soggybag/Casualty-6-SMD/Casualty6_render_bottom.png

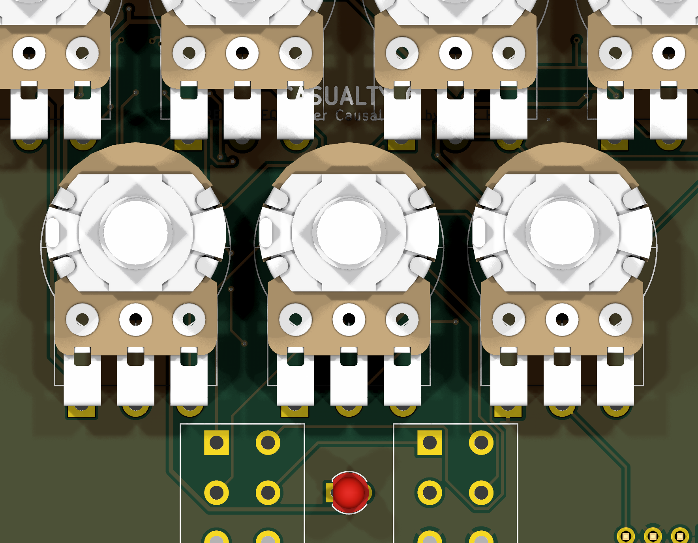
Casualty6_render_bottom.png
