soggybag/Casualty-6-SMD/Casualty6_render_top.png

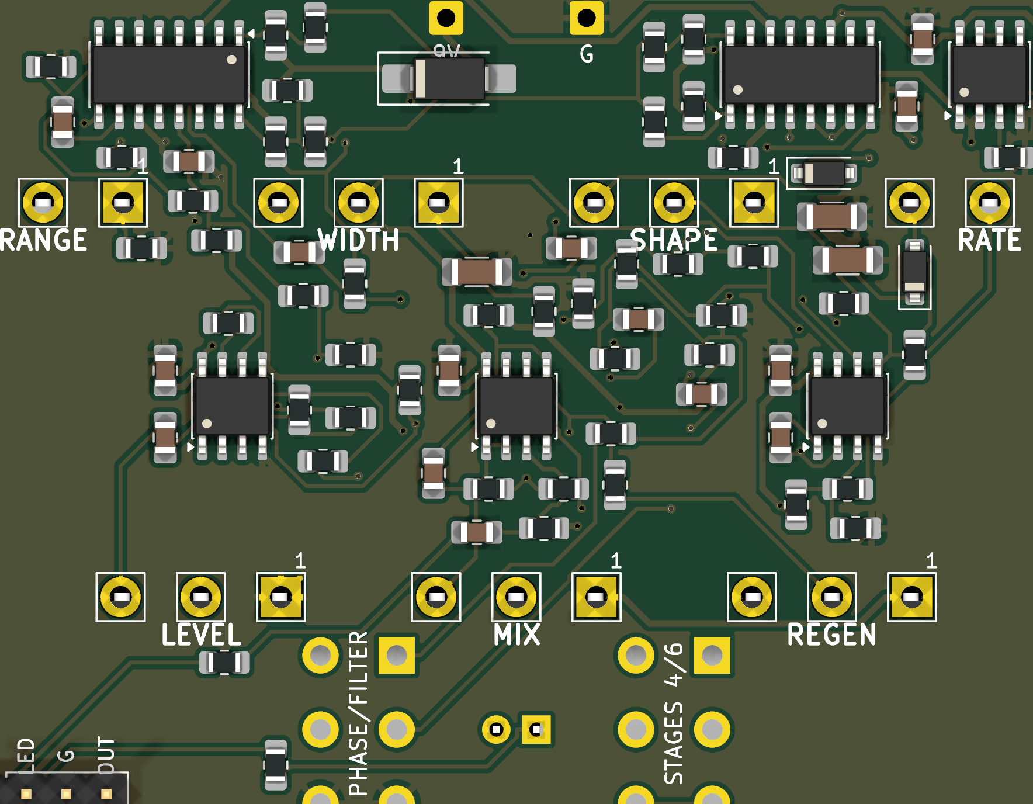
Casualty6_render_top.png
