soggybag/Casualty-6-SMD/archive/v1.0/parts.csv

Reference | Value | Footprint | Side | X mm | Y mm | Rotation | LCSC | Fitted by
C1 | 33n | Capacitor_SMD:C_0805_2012Metric_Pad1.18x1.45mm_HandSolder | front | 136.25 | 111.25 | 0.0 | C1739 | JLC
C2 | 33n | Capacitor_SMD:C_0805_2012Metric_Pad1.18x1.45mm_HandSolder | front | 121.25 | 103.0 | 90.0 | C1739 | JLC
C3 | 33n | Capacitor_SMD:C_0805_2012Metric_Pad1.18x1.45mm_HandSolder | front | 161.75 | 120.25 | 0.0 | C1739 | JLC
C4 | 33n | Capacitor_SMD:C_0805_2012Metric_Pad1.18x1.45mm_HandSolder | front | 153.5 | 111.0 | 0.0 | C1739 | JLC
C5 | 100n | Capacitor_SMD:C_0805_2012Metric_Pad1.18x1.45mm_HandSolder | front | 147.5 | 129.0 | 0.0 | C49678 | JLC
C6 | 4n7 | Capacitor_SMD:C_0805_2012Metric_Pad1.18x1.45mm_HandSolder | front | 144.75 | 125.25 | 90.0 | C1744 | JLC
C7 | 47n | Capacitor_SMD:C_0805_2012Metric_Pad1.18x1.45mm_HandSolder | front | 157.75 | 115.5 | 0.0 | C53134 | JLC
C8 | 1u | Capacitor_SMD:C_0805_2012Metric_Pad1.18x1.45mm_HandSolder | front | 127.75 | 123.0 | 90.0 | C28323 | JLC
C9 | 10n | Capacitor_SMD:C_0805_2012Metric_Pad1.18x1.45mm_HandSolder | front | 166.75 | 123.0 | 90.0 | C1710 | JLC
C10 | 22u | Capacitor_SMD:C_1206_3216Metric_Pad1.33x1.80mm_HandSolder | front | 170.0 | 109.0 | 0.0 | C12891 | JLC
C11 | 22u | Capacitor_SMD:C_1206_3216Metric_Pad1.33x1.80mm_HandSolder | front | 171.0 | 111.75 | 0.0 | C12891 | JLC
C12 | 22u | Capacitor_SMD:C_1206_3216Metric_Pad1.33x1.80mm_HandSolder | front | 147.5 | 112.5 | 0.0 | C12891 | JLC
C13 | 22u | Capacitor_SMD:C_1206_3216Metric_Pad1.33x1.80mm_HandSolder | front | 186.75 | 111.25 | 0.0 | C12891 | JLC
C14 | 10u | Capacitor_SMD:C_0805_2012Metric_Pad1.18x1.45mm_HandSolder | front | 185.0 | 100.25 | 0.0 | C15850 | JLC
C15 | 100n | Capacitor_SMD:C_0805_2012Metric_Pad1.18x1.45mm_HandSolder | front | 129.25 | 105.5 | 0.0 | C49678 | JLC
C16 | 100n | Capacitor_SMD:C_0805_2012Metric_Pad1.18x1.45mm_HandSolder | front | 174.75 | 102.0 | 90.0 | C49678 | JLC
C17 | 100n | Capacitor_SMD:C_0805_2012Metric_Pad1.18x1.45mm_HandSolder | front | 145.75 | 118.75 | 90.0 | C49678 | JLC
C18 | 100n | Capacitor_SMD:C_0805_2012Metric_Pad1.18x1.45mm_HandSolder | front | 127.75 | 118.75 | 90.0 | C49678 | JLC
C19 | 100n | Capacitor_SMD:C_0805_2012Metric_Pad1.18x1.45mm_HandSolder | front | 175.75 | 97.75 | 90.0 | C49678 | JLC
C20 | 100n | Capacitor_SMD:C_0805_2012Metric_Pad1.18x1.45mm_HandSolder | front | 166.75 | 118.75 | 90.0 | C49678 | JLC
D1 | 1N4148W | Diode_SMD:D_SOD-123 | front | 169.5 | 106.25 | 0.0 | C81598 | JLC
D2 | 1N4148W | Diode_SMD:D_SOD-123 | front | 175.25 | 112.5 | 90.0 | C81598 | JLC
D3 | SS14 | Diode_SMD:D_SMA_Handsoldering | front | 145.75 | 100.25 | 0.0 | C2480 | JLC
D4 | LED | LED_THT:LED_D3.0mm | back | 151.27 | 141.5 | 180.0 |  | hand
J1 | 9V | Connector_Wire:SolderWire-0.5sqmm_1x01_D0.9mm_OD2.1mm | front | 145.55 | 96.4 | 0.0 |  | hand
J2 | G | Connector_Wire:SolderWire-0.5sqmm_1x01_D0.9mm_OD2.1mm | front | 154.45 | 96.4 | 0.0 |  | hand
J3 | IN/LED/GND/OUT | Connector_PinHeader_2.54mm:PinHeader_1x04_P2.54mm_Vertical | front | 116.4 | 145.6 | 90.0 |  | hand
J4 | IG | Connector_Wire:SolderWire-0.5sqmm_1x01_D0.9mm_OD2.1mm | front | 187.6 | 96.4 | 0.0 |  | hand
J5 | OG | Connector_Wire:SolderWire-0.5sqmm_1x01_D0.9mm_OD2.1mm | front | 112.4 | 96.4 | 0.0 |  | hand
J6 | CV IN | Connector_Wire:SolderWire-0.5sqmm_1x01_D0.9mm_OD2.1mm | front | 112.5 | 102.5 | 0.0 |  | hand
J7 | LFO OUT | Connector_Wire:SolderWire-0.5sqmm_1x01_D0.9mm_OD2.1mm | front | 112.5 | 114.0 | 0.0 |  | hand
R1 | 27k | Resistor_SMD:R_0805_2012Metric_Pad1.20x1.40mm_HandSolder | front | 139.75 | 113.25 | 90.0 | C17593 | JLC
R2 | 27k | Resistor_SMD:R_0805_2012Metric_Pad1.20x1.40mm_HandSolder | front | 125.0 | 105.25 | 0.0 | C17593 | JLC
R3 | 2k | Resistor_SMD:R_0805_2012Metric_Pad1.20x1.40mm_HandSolder | front | 134.75 | 104.25 | 90.0 | C17604 | JLC
R4 | 10k | Resistor_SMD:R_0805_2012Metric_Pad1.20x1.40mm_HandSolder | front | 120.5 | 99.5 | 0.0 | C17414 | JLC
R5 | 15k | Resistor_SMD:R_0805_2012Metric_Pad1.20x1.40mm_HandSolder | front | 137.25 | 97.0 | 90.0 | C17475 | JLC
R6 | 470k | Resistor_SMD:R_0805_2012Metric_Pad1.20x1.40mm_HandSolder | front | 134.75 | 97.5 | 90.0 | C17709 | JLC
R7 | 27k | Resistor_SMD:R_0805_2012Metric_Pad1.20x1.40mm_HandSolder | front | 129.5 | 108.0 | 0.0 | C17593 | JLC
R8 | 27k | Resistor_SMD:R_0805_2012Metric_Pad1.20x1.40mm_HandSolder | front | 136.5 | 114.0 | 0.0 | C17593 | JLC
R9 | 2k | Resistor_SMD:R_0805_2012Metric_Pad1.20x1.40mm_HandSolder | front | 131.0 | 110.5 | 0.0 | C17604 | JLC
R10 | 10k | Resistor_SMD:R_0805_2012Metric_Pad1.20x1.40mm_HandSolder | front | 139.5 | 117.75 | 0.0 | C17414 | JLC
R11 | 15k | Resistor_SMD:R_0805_2012Metric_Pad1.20x1.40mm_HandSolder | front | 137.25 | 104.25 | 90.0 | C17475 | JLC
R12 | 470k | Resistor_SMD:R_0805_2012Metric_Pad1.20x1.40mm_HandSolder | front | 135.5 | 101.0 | 0.0 | C17709 | JLC
R13 | 27k | Resistor_SMD:R_0805_2012Metric_Pad1.20x1.40mm_HandSolder | front | 156.0 | 122.75 | 0.0 | C17593 | JLC
R14 | 27k | Resistor_SMD:R_0805_2012Metric_Pad1.20x1.40mm_HandSolder | front | 157.0 | 112.0 | 90.0 | C17593 | JLC
R15 | 2k | Resistor_SMD:R_0805_2012Metric_Pad1.20x1.40mm_HandSolder | front | 162.25 | 117.75 | 0.0 | C17604 | JLC
R16 | 10k | Resistor_SMD:R_0805_2012Metric_Pad1.20x1.40mm_HandSolder | front | 154.25 | 114.5 | 90.0 | C17414 | JLC
R17 | 15k | Resistor_SMD:R_0805_2012Metric_Pad1.20x1.40mm_HandSolder | front | 158.75 | 103.0 | 90.0 | C17475 | JLC
R18 | 470k | Resistor_SMD:R_0805_2012Metric_Pad1.20x1.40mm_HandSolder | front | 161.25 | 102.0 | 90.0 | C17709 | JLC
R19 | 27k | Resistor_SMD:R_0805_2012Metric_Pad1.20x1.40mm_HandSolder | front | 160.25 | 112.0 | 0.0 | C17593 | JLC
R20 | 27k | Resistor_SMD:R_0805_2012Metric_Pad1.20x1.40mm_HandSolder | front | 165.0 | 111.5 | 0.0 | C17593 | JLC
R21 | 2k | Resistor_SMD:R_0805_2012Metric_Pad1.20x1.40mm_HandSolder | front | 163.75 | 105.25 | 0.0 | C17604 | JLC
R22 | 10k | Resistor_SMD:R_0805_2012Metric_Pad1.20x1.40mm_HandSolder | front | 163.0 | 115.25 | 0.0 | C17414 | JLC
R23 | 15k | Resistor_SMD:R_0805_2012Metric_Pad1.20x1.40mm_HandSolder | front | 158.75 | 98.25 | 90.0 | C17475 | JLC
R24 | 470k | Resistor_SMD:R_0805_2012Metric_Pad1.20x1.40mm_HandSolder | front | 161.25 | 97.75 | 90.0 | C17709 | JLC
R25 | 1k | Resistor_SMD:R_0805_2012Metric_Pad1.20x1.40mm_HandSolder | front | 131.5 | 137.25 | 0.0 | C17513 | JLC
R26 | 1M | Resistor_SMD:R_0805_2012Metric_Pad1.20x1.40mm_HandSolder | front | 151.75 | 128.75 | 0.0 | C17514 | JLC
R27 | 10k | Resistor_SMD:R_0805_2012Metric_Pad1.20x1.40mm_HandSolder | front | 148.25 | 126.25 | 0.0 | C17414 | JLC
R28 | 10k | Resistor_SMD:R_0805_2012Metric_Pad1.20x1.40mm_HandSolder | front | 148.25 | 115.25 | 0.0 | C17414 | JLC
R29 | 10k | Resistor_SMD:R_0805_2012Metric_Pad1.20x1.40mm_HandSolder | front | 153.0 | 126.25 | 0.0 | C17414 | JLC
R30 | 15k | Resistor_SMD:R_0805_2012Metric_Pad1.20x1.40mm_HandSolder | front | 156.25 | 126.0 | 90.0 | C17475 | JLC
R31 | 10k | Resistor_SMD:R_0805_2012Metric_Pad1.20x1.40mm_HandSolder | front | 156.25 | 118.0 | 0.0 | C17414 | JLC
R32 | 10k | Resistor_SMD:R_0805_2012Metric_Pad1.20x1.40mm_HandSolder | front | 143.25 | 120.0 | 90.0 | C17414 | JLC
R33 | 10k | Resistor_SMD:R_0805_2012Metric_Pad1.20x1.40mm_HandSolder | front | 139.5 | 121.75 | 0.0 | C17414 | JLC
R34 | 47k | Resistor_SMD:R_0805_2012Metric_Pad1.20x1.40mm_HandSolder | front | 137.75 | 124.5 | 0.0 | C17713 | JLC
R35 | 47k | Resistor_SMD:R_0805_2012Metric_Pad1.20x1.40mm_HandSolder | front | 136.25 | 121.25 | 90.0 | C17713 | JLC
R36 | 68k | Resistor_SMD:R_0805_2012Metric_Pad1.20x1.40mm_HandSolder | front | 131.75 | 115.75 | 0.0 | C17801 | JLC
R37 | 220k | Resistor_SMD:R_0805_2012Metric_Pad1.20x1.40mm_HandSolder | front | 171.5 | 128.75 | 0.0 | C17556 | JLC
R38 | 220k | Resistor_SMD:R_0805_2012Metric_Pad1.20x1.40mm_HandSolder | front | 167.75 | 127.25 | 90.0 | C17556 | JLC
R39 | 220k | Resistor_SMD:R_0805_2012Metric_Pad1.20x1.40mm_HandSolder | front | 171.0 | 126.25 | 0.0 | C17556 | JLC
R40 | 220k | Resistor_SMD:R_0805_2012Metric_Pad1.20x1.40mm_HandSolder | front | 170.75 | 114.5 | 0.0 | C17556 | JLC
R41 | 1k | Resistor_SMD:R_0805_2012Metric_Pad1.20x1.40mm_HandSolder | front | 175.25 | 117.75 | 90.0 | C17513 | JLC
R42 | 47k | Resistor_SMD:R_0805_2012Metric_Pad1.20x1.40mm_HandSolder | front | 151.75 | 115.0 | 90.0 | C17713 | JLC
R43 | 2k2 | Resistor_SMD:R_0805_2012Metric_Pad1.20x1.40mm_HandSolder | front | 126.25 | 111.0 | 0.0 | C17520 | JLC
R44 | 1k | Resistor_SMD:R_0805_2012Metric_Pad1.20x1.40mm_HandSolder | front | 187.0 | 104.25 | 90.0 | C17513 | JLC
R45 | 100k | Resistor_SMD:R_0805_2012Metric_Pad1.20x1.40mm_HandSolder | front | 184.5 | 103.75 | 90.0 | C149504 | JLC
R46 | 100k | Resistor_SMD:R_0805_2012Metric_Pad1.20x1.40mm_HandSolder | front | 181.25 | 105.25 | 0.0 | C149504 | JLC
R47 | 4k7 | Resistor_SMD:R_0805_2012Metric_Pad1.20x1.40mm_HandSolder | front | 134.75 | 143.75 | 90.0 | C17673 | JLC
R48 | 10k | Resistor_SMD:R_0805_2012Metric_Pad1.20x1.40mm_HandSolder | front | 188.0 | 100.1 | 90.0 | C17414 | JLC
R49 | 6k8 | Resistor_SMD:R_0805_2012Metric_Pad1.20x1.40mm_HandSolder | front | 180.0 | 95.3 | 180.0 | C17772 | JLC
R50 | 10k | Resistor_SMD:R_0805_2012Metric_Pad1.20x1.40mm_HandSolder | front | 183.8 | 97.3 | 90.0 | C17414 | JLC
R51 | 10k | Resistor_SMD:R_0805_2012Metric_Pad1.20x1.40mm_HandSolder | front | 116.0 | 102.5 | 90.0 | C17414 | JLC
R52 | 1k | Resistor_SMD:R_0805_2012Metric_Pad1.20x1.40mm_HandSolder | front | 167.8 | 114.9 | 90.0 | C17513 | JLC
R53 | 1M | Resistor_SMD:R_0805_2012Metric_Pad1.20x1.40mm_HandSolder | front | 132.25 | 139.75 | 0.0 | C17514 | JLC
RV1 | C500k | UglyFace:Potentiometer_Alpha_16mm_Vertical | front | 180.0 | 108.11 | 0.0 |  | hand
RV2 | B1M | UglyFace:Potentiometer_Alpha_16mm_Vertical | front | 160.0 | 108.11 | 0.0 |  | hand
RV3 | B100k | UglyFace:Potentiometer_Alpha_16mm_Vertical | front | 140.0 | 108.11 | 0.0 |  | hand
RV4 | B10k | UglyFace:Potentiometer_Alpha_16mm_Vertical | front | 120.0 | 108.11 | 0.0 |  | hand
RV5 | B50k | UglyFace:Potentiometer_Alpha_16mm_Vertical | front | 170.0 | 133.1 | 0.0 |  | hand
RV6 | A100k | UglyFace:Potentiometer_Alpha_16mm_Vertical | front | 150.0 | 133.1 | 0.0 |  | hand
RV7 | A100k | UglyFace:Potentiometer_Alpha_16mm_Vertical | front | 130.0 | 133.1 | 0.0 |  | hand
SW1 | DPDT | Casualty:SW_Taiway_100_DPDT_PC | back | 160.0 | 141.5 | 0.0 |  | hand
SW2 | DPDT | Casualty:SW_Taiway_100_DPDT_PC | back | 140.0 | 141.5 | 0.0 |  | hand
U1 | LM13700 | Package_SO:SOIC-16_3.9x9.9mm_P1.27mm | front | 128.0 | 100.0 | -90.0 | C1346265 | JLC
U2 | LM13700 | Package_SO:SOIC-16_3.9x9.9mm_P1.27mm | front | 168.0 | 100.0 | 90.0 | C1346265 | JLC
U3 | TL072 | Package_SO:SOIC-8_3.9x4.9mm_P1.27mm | front | 150.0 | 121.0 | 90.0 | C6961 | JLC
U4 | TL072 | Package_SO:SOIC-8_3.9x4.9mm_P1.27mm | front | 132.0 | 121.0 | 90.0 | C6961 | JLC
U5 | TL072 | Package_SO:SOIC-8_3.9x4.9mm_P1.27mm | front | 180.0 | 100.0 | 90.0 | C6961 | JLC
U6 | TL072 | Package_SO:SOIC-8_3.9x4.9mm_P1.27mm | front | 171.0 | 121.0 | 90.0 | C6961 | JLC
