soggybag/Casualty-6-SMD/3dmodels/RV16AF-41.step

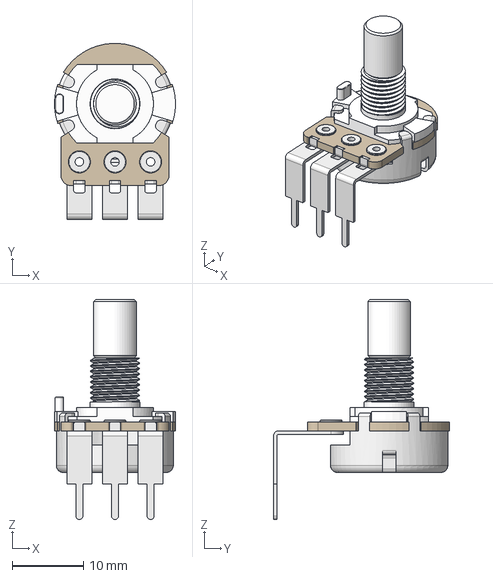
[picture p3: CAD file, 2026-10-15]
3dmodels/RV16AF-41.step
17.0 x 24.7 x 30.9 mm
