soggybag/Casualty-6-SMD/3dmodels/1590B.stp

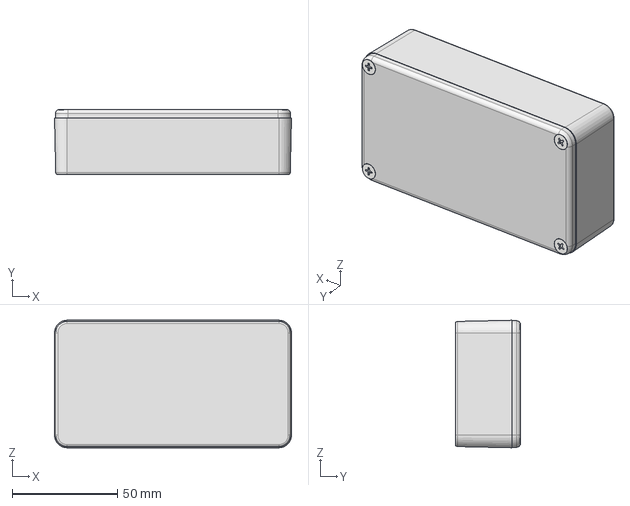
[picture p4: CAD file, 2026-10-15]
3dmodels/1590B.stp
112.4 x 31.0 x 60.5 mm
