soggybag/Casualty-6-SMD/Casualty6.pdf

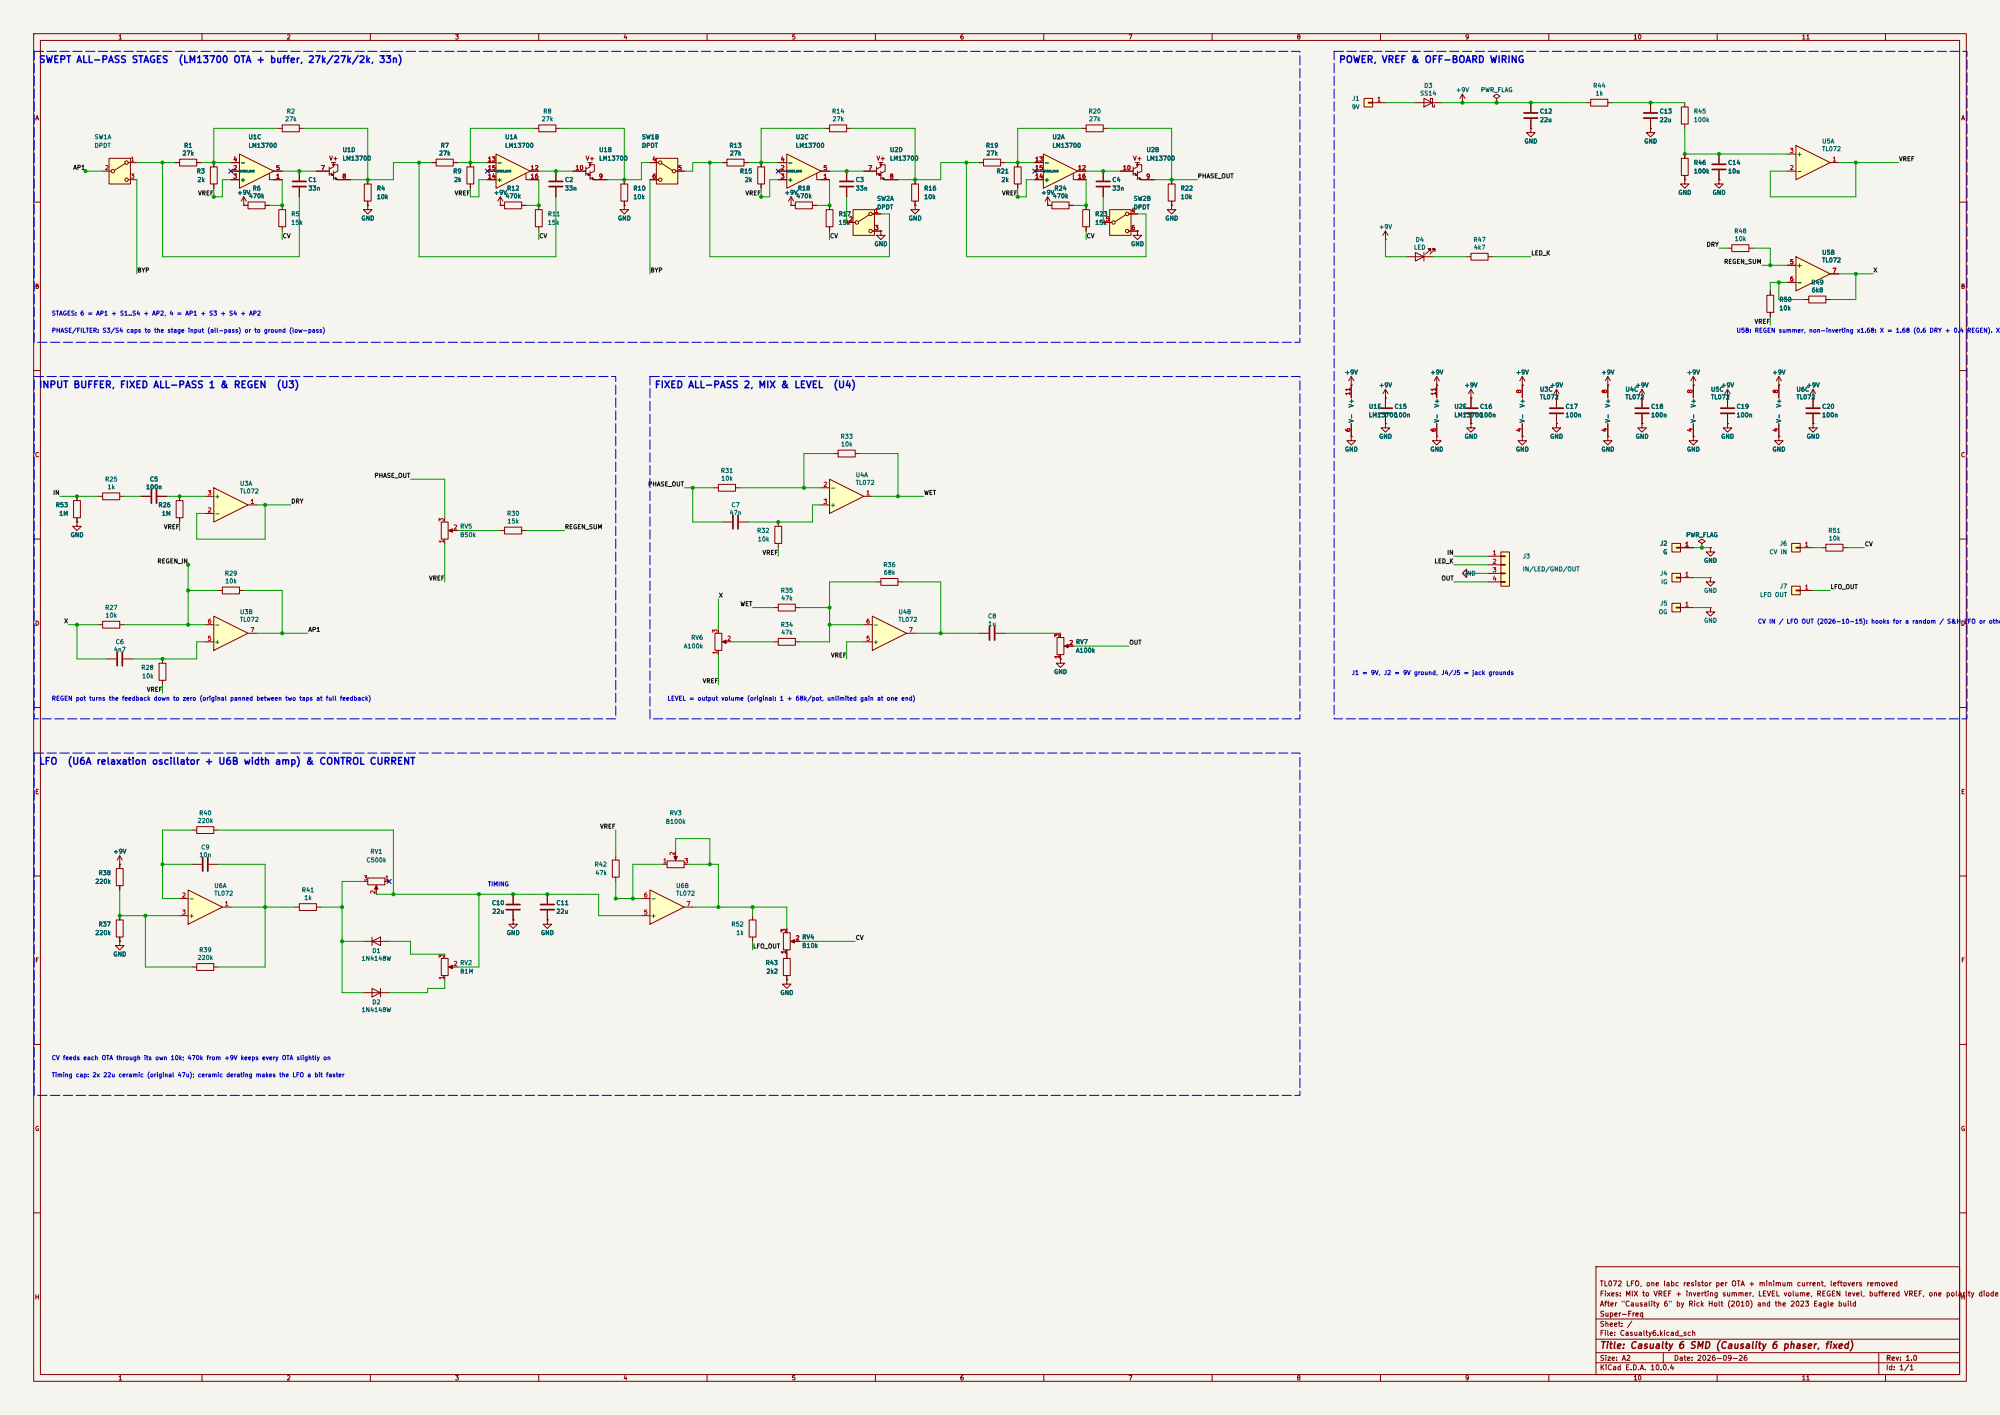
[picture p5: page 1]

SWEPT ALL-PASS STAGES (LM13700 OTA + buffer, 27k/27k/2k, 33n)

POWER, VREF & OFF-BOARD WIRING
1k GND

PHASE/FILTER: S3/S4 caps to the stage input (all-pass) or to ground (low-pass) STAGES: 6 = AP1 + S1..S4 + AP2, 4 = AP1 + S3 + S4 + AP2 LFO (U6A relaxation oscillator + U6B width amp) & CONTROL CURRENT

INPUT BUFFER, FIXED ALL-PASS 1 & REGEN (U3)

IN/LED/GND/OUT

REGEN pot turns the feedback down to zero (original panned between two taps at full feedback) CV feeds each OTA through its own 10k; 470k from +9V keeps every OTA slightly on

LEVEL = output volume (original: 1 + 68k/pot, unlimited gain at one end)

TL072 LFO, one Iabc resistor per OTA + minimum current, leftovers removed
Fixes: MIX to VREF + inverting summer, LEVEL volume, REGEN level, buffered VREF, one polarity diode
After "Causality 6" by Rick Holt (2010) and the 2023 Eagle build
Super-Freq
Sheet: /
File: Casualty6.kicad_sch
Title: Casualty 6 SMD (Causality 6 phaser, fixed)

Size: A2 | Rev: 1.0
KiCad E.D.A. 10.0.4 | Id: 1/1
