soggybag/Casualty-6-SMD/archive/v1.0/Casualty6_board_front.pdf

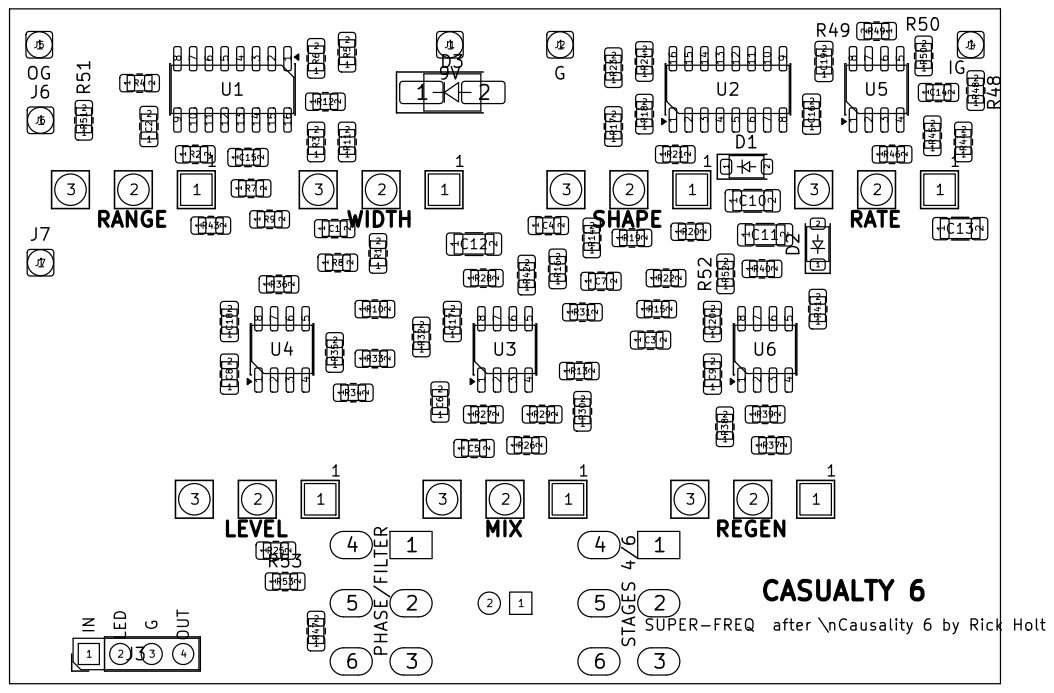
[picture p6: page 1]

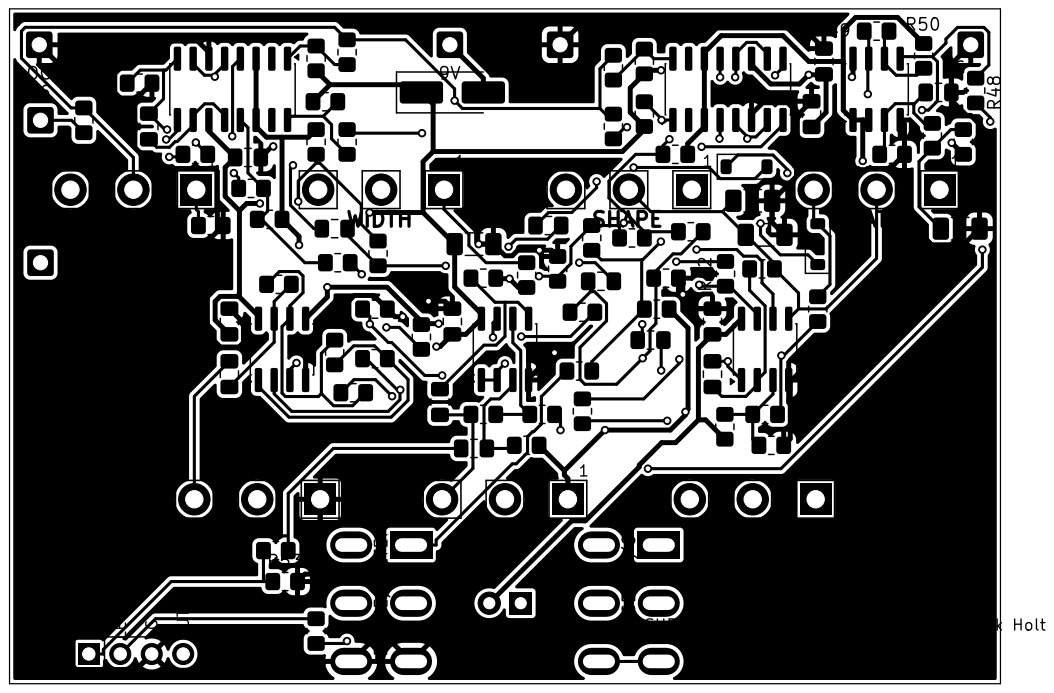
[picture p7: page 2]

INSUPER-FREQ after \nCausality 6 by Rick Holt LEDGOUT OG 9V G IG PHASE/FILTER STAGES 4/6
