soggybag/Casualty-6-SMD/archive/v1.0/Casualty6_board_back.pdf

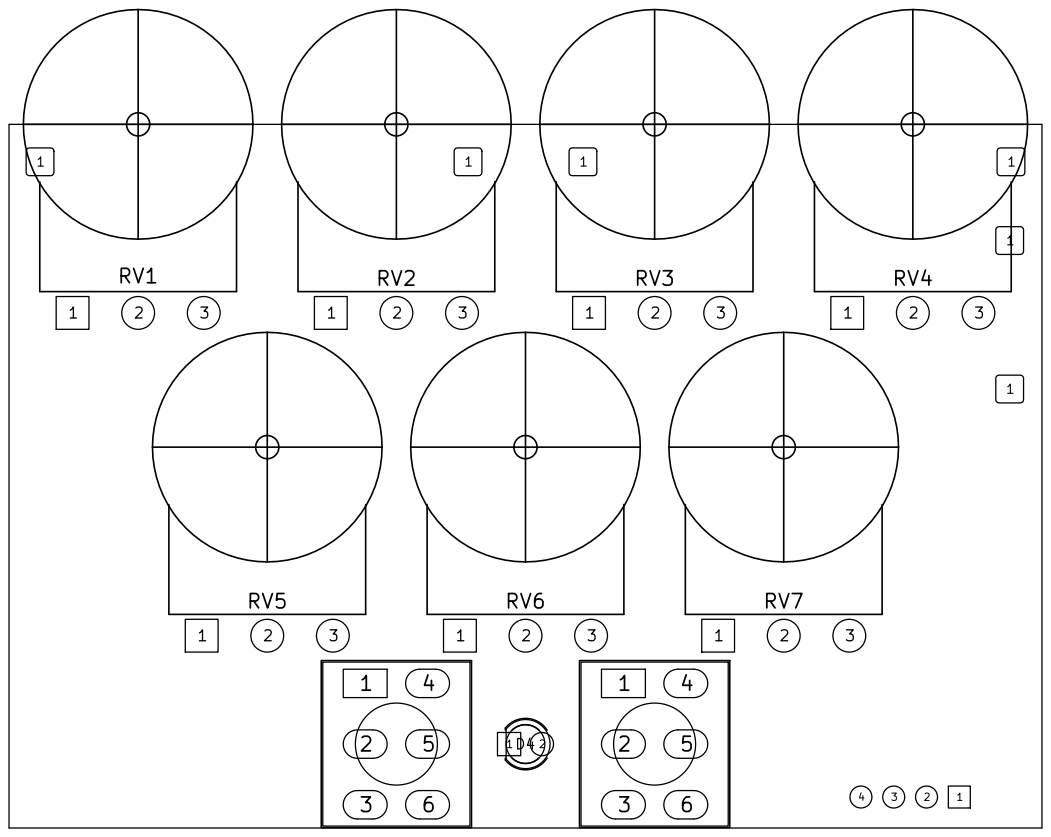
[picture p8: page 1]

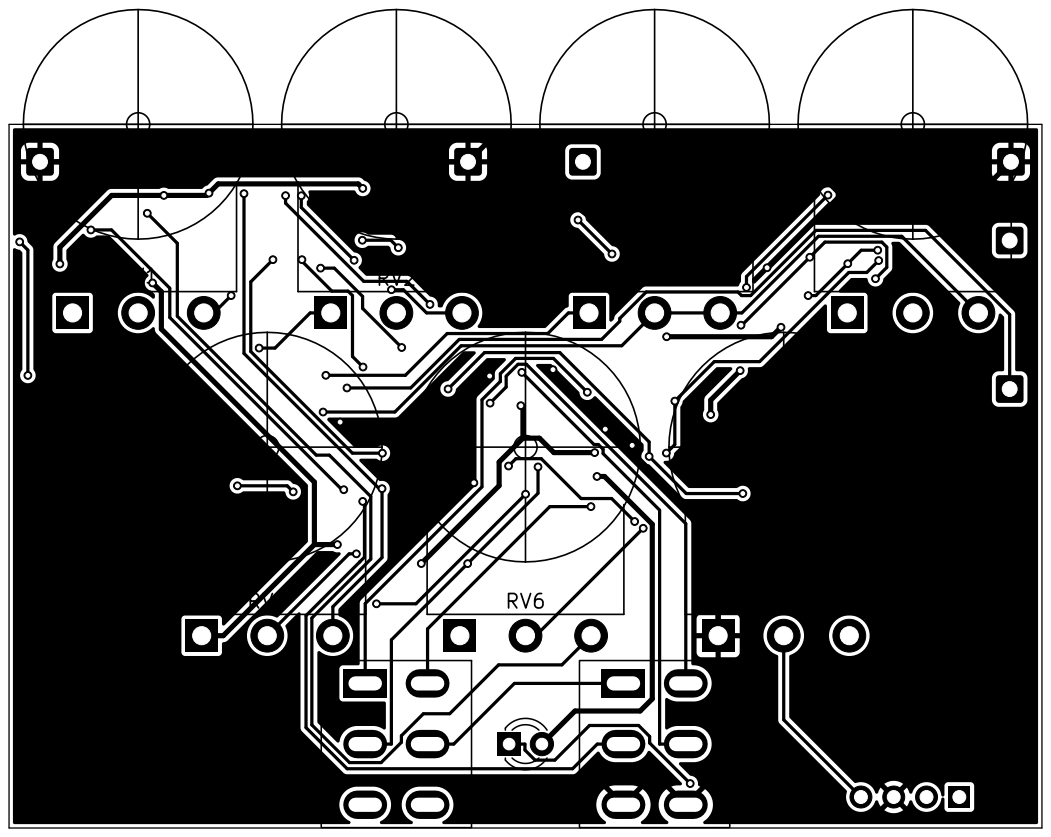
[picture p9: page 2]
