soggybag/Casualty-6-SMD/Casualty6.kicad_pcb

## KiCad design Casualty6.kicad_pcb (2026-10-20)

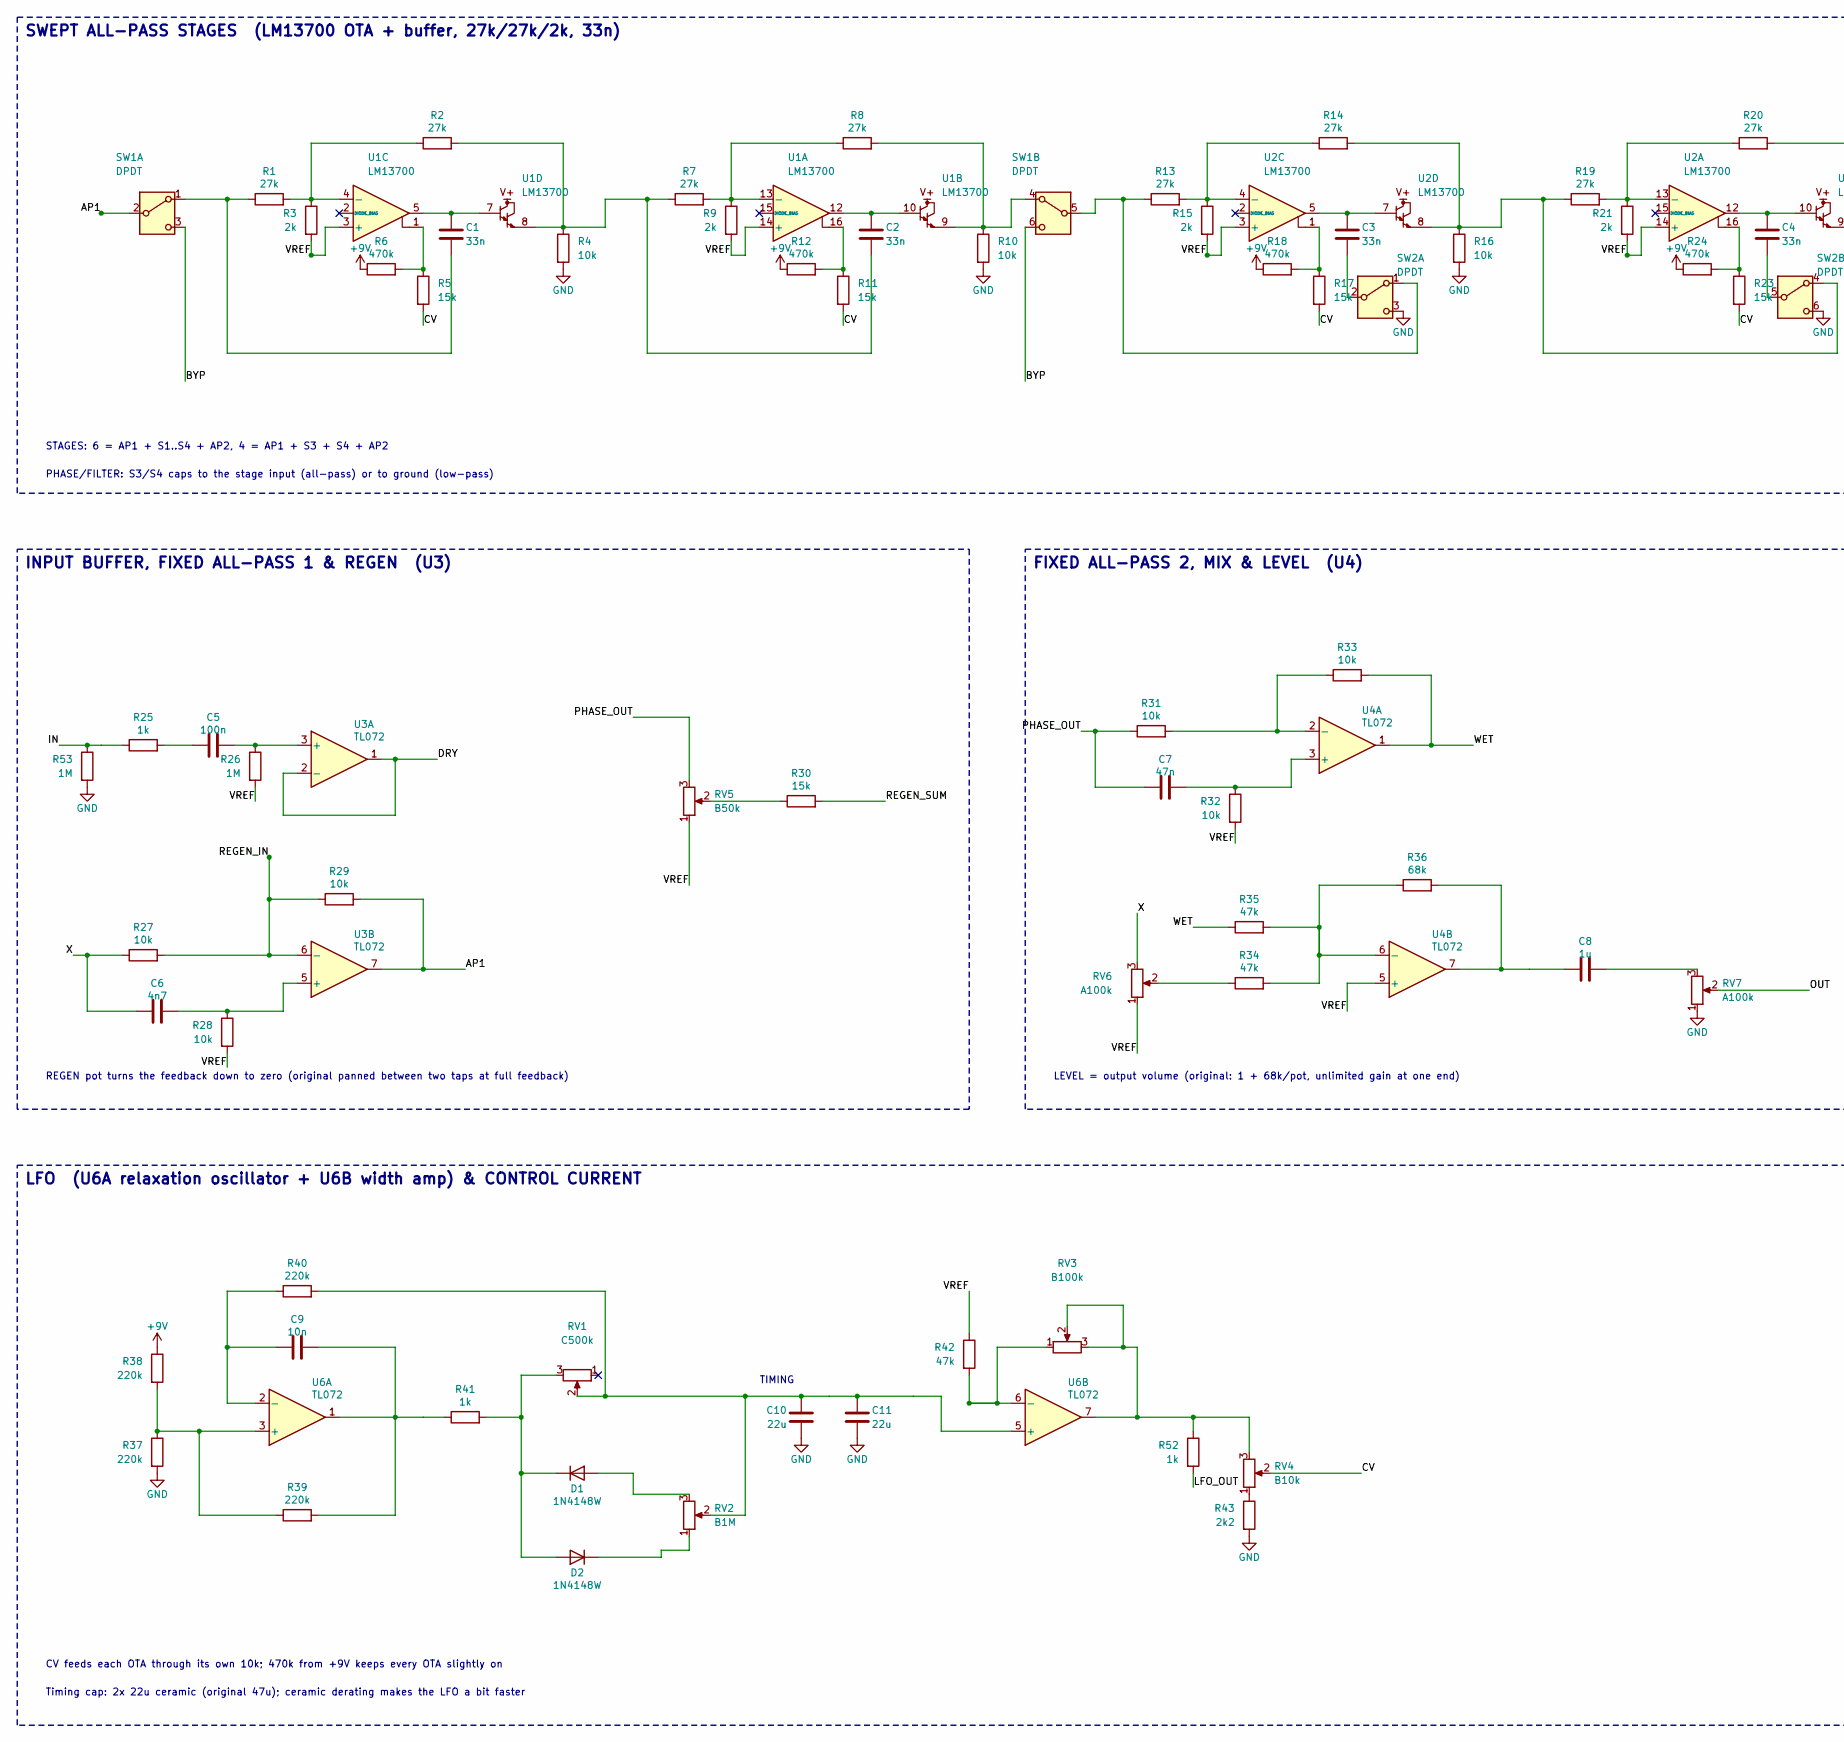
[picture p10: schematic Casualty6.kicad_sch, Casualty 6 SMD (Causality 6 phaser, fixed), part in row 1, column 1]

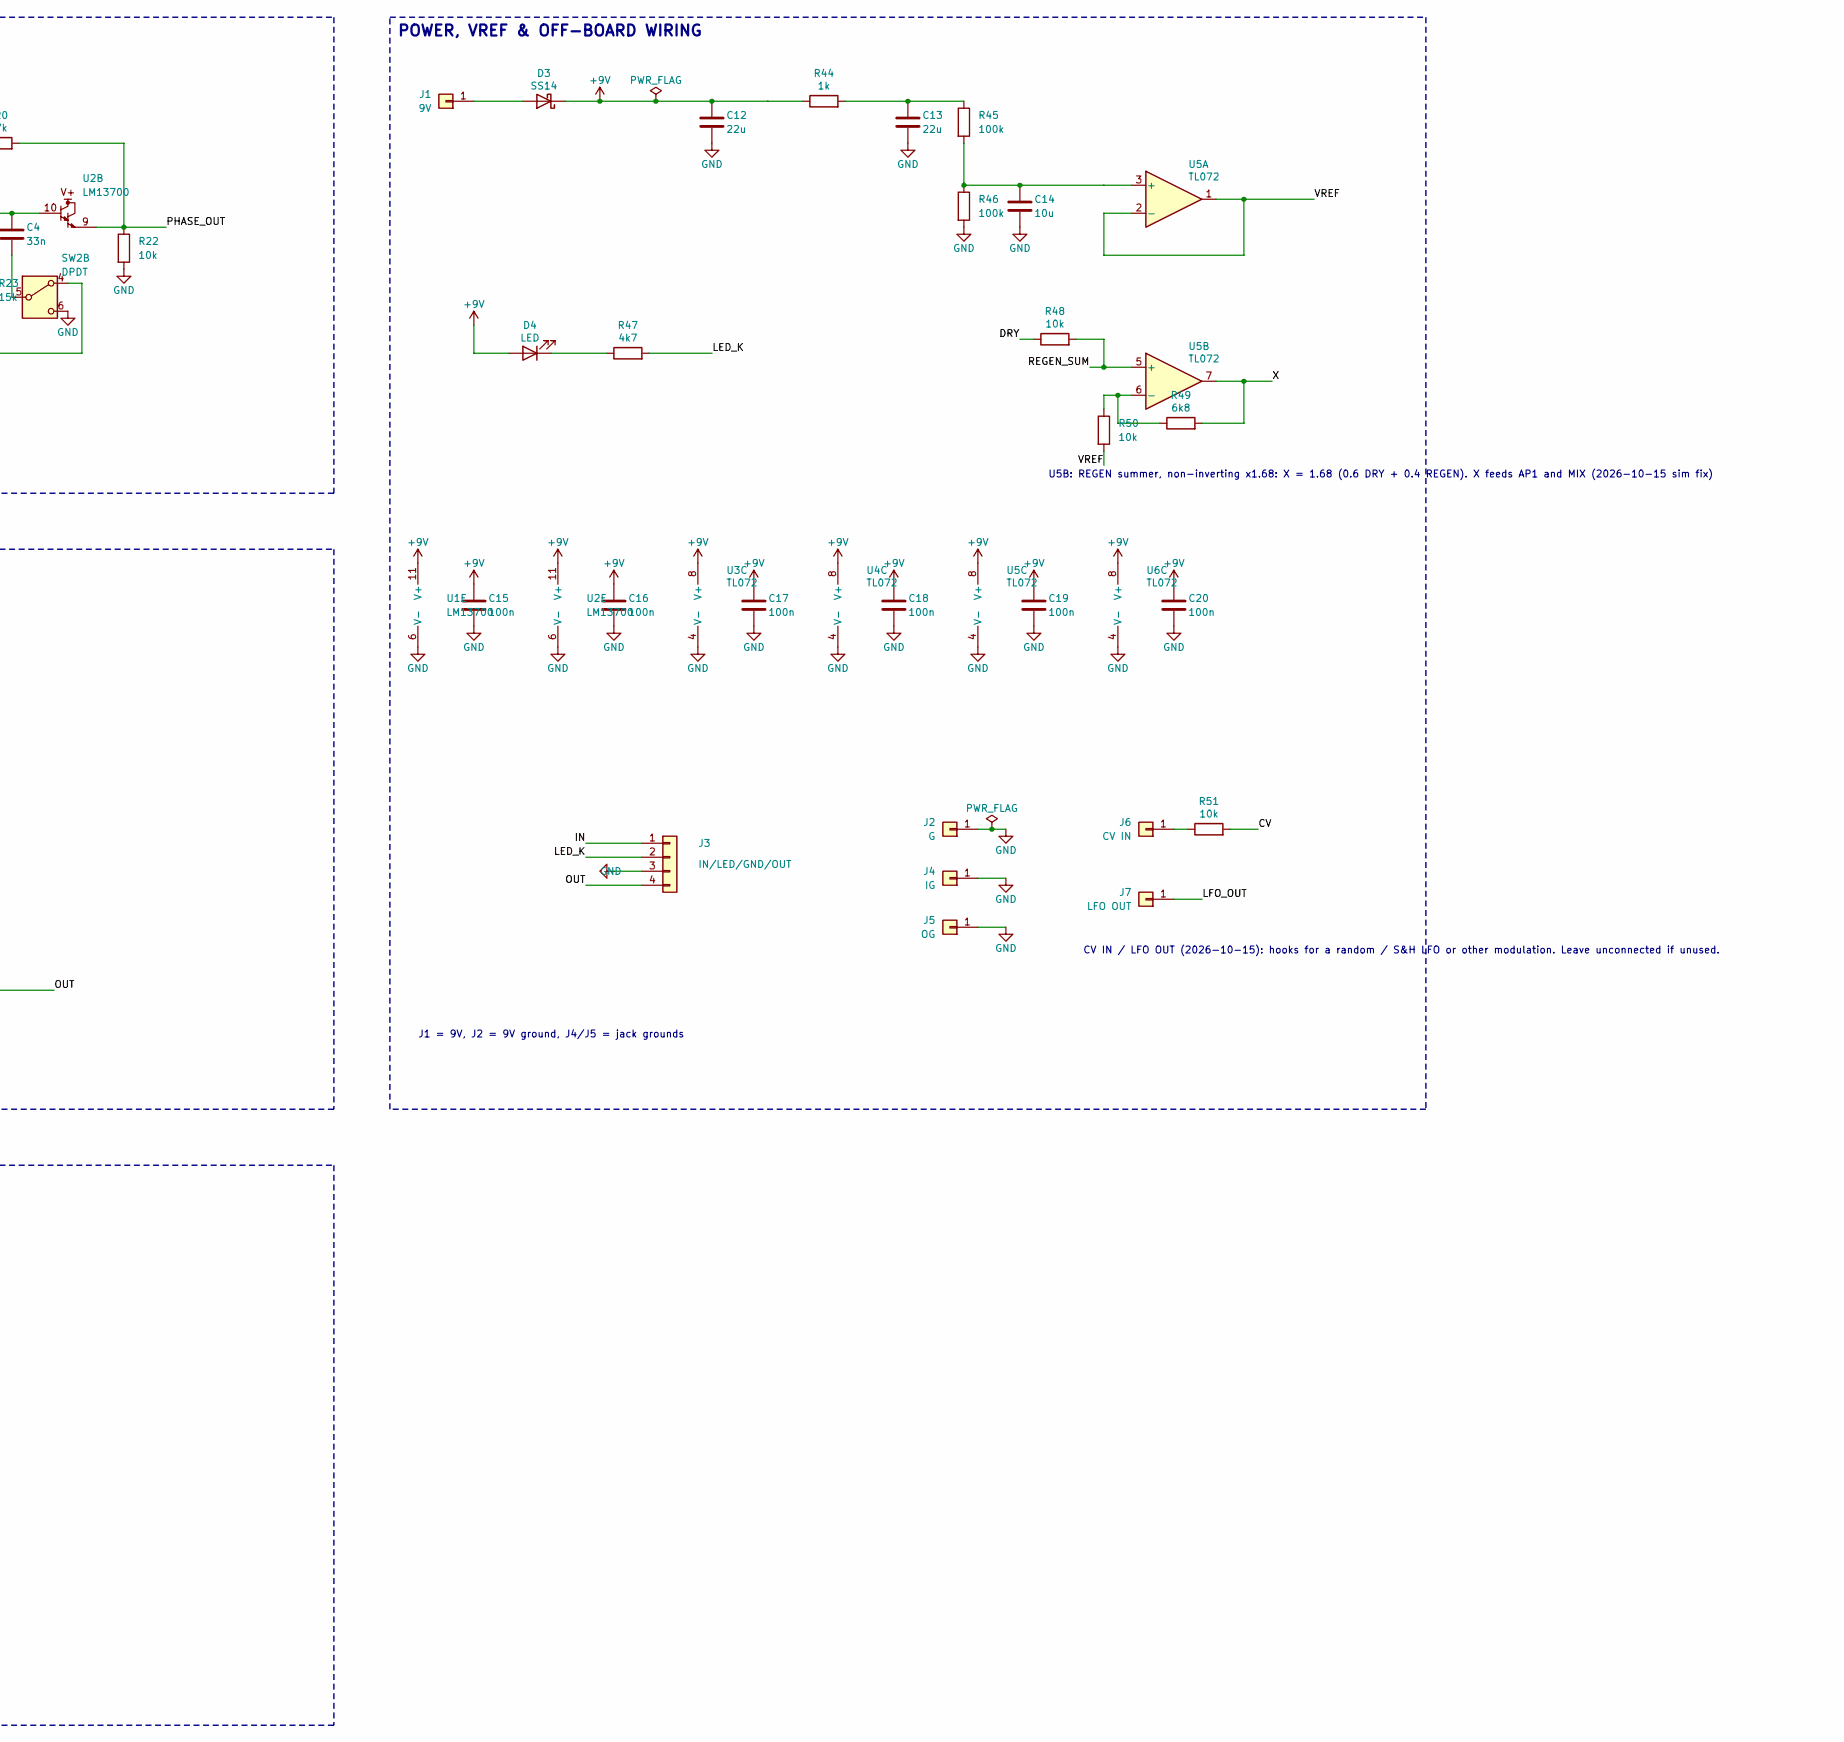
[picture p11: schematic Casualty6.kicad_sch, Casualty 6 SMD (Causality 6 phaser, fixed), part in row 1, column 2]

Parts:
C1, C2, C3, C4: 33n; C_0805_2012Metric_Pad1.18x1.45mm_HandSolder; LCSC C1739
C5, C15, C16, C17, C18, C19, C20: 100n; C_0805_2012Metric_Pad1.18x1.45mm_HandSolder; LCSC C49678
C6: 4n7; C_0805_2012Metric_Pad1.18x1.45mm_HandSolder; LCSC C1744
C7: 47n; C_0805_2012Metric_Pad1.18x1.45mm_HandSolder; LCSC C53134
C8: 1u; C_0805_2012Metric_Pad1.18x1.45mm_HandSolder; LCSC C28323
C9: 10n; C_0805_2012Metric_Pad1.18x1.45mm_HandSolder; LCSC C1710
C10, C11, C12, C13: 22u; C_1206_3216Metric_Pad1.33x1.80mm_HandSolder; LCSC C12891
C14: 10u; C_0805_2012Metric_Pad1.18x1.45mm_HandSolder; LCSC C15850
D1, D2: 1N4148W; D_SOD-123; LCSC C81598
D3: SS14; D_SMA_Handsoldering; LCSC C2480
D4: LED; LED_D3.0mm
J1: 9V; SolderWire-0.5sqmm_1x01_D0.9mm_OD2.1mm
J2: G; SolderWire-0.5sqmm_1x01_D0.9mm_OD2.1mm
J3: IN/LED/GND/OUT; PinHeader_1x04_P2.54mm_Vertical
J4: IG; SolderWire-0.5sqmm_1x01_D0.9mm_OD2.1mm
J5: OG; SolderWire-0.5sqmm_1x01_D0.9mm_OD2.1mm
J6: CV IN; SolderWire-0.5sqmm_1x01_D0.9mm_OD2.1mm
J7: LFO OUT; SolderWire-0.5sqmm_1x01_D0.9mm_OD2.1mm
R1, R2, R7, R8, R13, R14, R19, R20: 27k; R_0805_2012Metric_Pad1.20x1.40mm_HandSolder; LCSC C17593
R3, R9, R15, R21: 2k; R_0805_2012Metric_Pad1.20x1.40mm_HandSolder; LCSC C17604
R4, R10, R16, R22, R27, R28, R29, R31, R32, R33, R48, R50, R51: 10k; R_0805_2012Metric_Pad1.20x1.40mm_HandSolder; LCSC C17414
R5, R11, R17, R23, R30: 15k; R_0805_2012Metric_Pad1.20x1.40mm_HandSolder; LCSC C17475
R6, R12, R18, R24: 470k; R_0805_2012Metric_Pad1.20x1.40mm_HandSolder; LCSC C17709
R25, R41, R44, R52: 1k; R_0805_2012Metric_Pad1.20x1.40mm_HandSolder; LCSC C17513
R26, R53: 1M; R_0805_2012Metric_Pad1.20x1.40mm_HandSolder; LCSC C17514
R34, R35, R42: 47k; R_0805_2012Metric_Pad1.20x1.40mm_HandSolder; LCSC C17713
R36: 68k; R_0805_2012Metric_Pad1.20x1.40mm_HandSolder; LCSC C17801
R37, R38, R39, R40: 220k; R_0805_2012Metric_Pad1.20x1.40mm_HandSolder; LCSC C17556
R43: 2k2; R_0805_2012Metric_Pad1.20x1.40mm_HandSolder; LCSC C17520
R45, R46: 100k; R_0805_2012Metric_Pad1.20x1.40mm_HandSolder; LCSC C149504
R47: 4k7; R_0805_2012Metric_Pad1.20x1.40mm_HandSolder; LCSC C17673
R49: 6k8; R_0805_2012Metric_Pad1.20x1.40mm_HandSolder; LCSC C17772
RV1: C500k; Potentiometer_Alpha_16mm_Vertical
RV2: B1M; Potentiometer_Alpha_16mm_Vertical
RV3: B100k; Potentiometer_Alpha_16mm_Vertical
RV4: B10k; Potentiometer_Alpha_16mm_Vertical
RV5: B50k; Potentiometer_Alpha_16mm_Vertical
RV6, RV7: A100k; Potentiometer_Alpha_16mm_Vertical
SW1, SW2: DPDT; SW_Taiway_100_DPDT_PC
U1, U2: LM13700; SOIC-16_3.9x9.9mm_P1.27mm; LCSC C1346265
U3, U4, U5, U6: TL072; SOIC-8_3.9x4.9mm_P1.27mm; LCSC C6961

Connections:
/AP1: R29.2, SW1.2 (B), U3.7
/BYP: SW1.3 (C), SW1.6 (C)
/CV: R5.2, R11.2, R17.2, R23.2, R51.2, RV4.2
/DRY: R48.1, U3.1, U3.2 (-)
/IN: J3.1, R25.1, R53.1
/LED_K: J3.2, R47.2
/LFO_OUT: J7.1, R52.2
/OUT: J3.4, RV7.2
/PHASE_OUT: C7.1, R20.2, R22.1, R31.1, RV5.3, U2.9
/REGEN_IN: R27.2, R29.1, U3.6 (-)
/REGEN_SUM: R30.2, R48.2, U5.5 (+)
/VREF: R3.2, R9.2, R15.2, R21.2, R26.2, R28.2, R32.2, R42.1, R50.2, RV5.1, RV6.1, U1.3 (+), U1.14 (+), U2.3 (+), U2.14 (+), U4.5 (+), U5.1, U5.2 (-)
/WET: R33.2, R35.1, U4.1
/X: C6.1, R27.1, R49.2, RV6.3, U5.7
unnamed: C1.1, U1.5, U1.7
unnamed: C2.1, U1.10, U1.12
unnamed: C2.2, R2.2, R4.1, R7.1, U1.8
unnamed: C3.1, U2.5, U2.7
unnamed: C4.1, U2.10, U2.12
unnamed: C5.1, R25.2
unnamed: C8.1, R36.2, U4.7
unnamed: C8.2, RV7.3
unnamed: C9.2, R39.2, R41.1, U6.1
unnamed: C13.1, R44.2, R45.1
unnamed: D1.2 (A), RV2.3
unnamed: D1.1 (K), D2.2 (A), R41.2, RV1.3
unnamed: D2.1 (K), RV2.1
unnamed: D3.2 (A), J1.1
unnamed: D4.1 (K), R47.1
unnamed: J6.1, R51.1
unnamed: R5.1, R6.2, U1.1
unnamed: R11.1, R12.2, U1.16
unnamed: R17.1, R18.2, U2.1
unnamed: R23.1, R24.2, U2.16
unnamed: R30.1, RV5.2
unnamed: R34.1, RV6.2
unnamed: R43.1, RV4.1
unnamed: R52.1, RV3.2, RV3.3, RV4.3, U6.7
unnamed: C1.2, R1.1, SW1.1 (A)
unnamed: R8.2, R10.1, SW1.4 (A), U1.9
unnamed: R13.1, SW1.5 (B), SW2.1 (A)
unnamed: C3.2, SW2.2 (B)
unnamed: R14.2, R16.1, R19.1, SW2.4 (A), U2.8
unnamed: C4.2, SW2.5 (B)
unnamed: R7.2, R8.1, R9.1, U1.13 (-)
unnamed: R1.2, R2.1, R3.1, U1.4 (-)
unnamed: R19.2, R20.1, R21.1, U2.13 (-)
unnamed: R13.2, R14.1, R15.1, U2.4 (-)
unnamed: C5.2, R26.1, U3.3 (+)
unnamed: C6.2, R28.1, U3.5 (+)
unnamed: C7.2, R32.1, U4.3 (+)
unnamed: R31.2, R33.1, U4.2 (-)
unnamed: R34.2, R35.2, R36.1, U4.6 (-)
unnamed: C14.1, R45.2, R46.1, U5.3 (+)
unnamed: R49.1, R50.1, U5.6 (-)
unnamed: R37.1, R38.2, R39.1, U6.3 (+)
unnamed: C9.1, R40.1, U6.2 (-)
unnamed: C10.1, C11.1, R40.2, RV1.2, RV2.2, U6.5 (+)
unnamed: R42.2, RV3.1, U6.6 (-)

Notes on the sheet:
CV IN / LFO OUT (2026-10-15): hooks for a random / S&H LFO or other modulation. Leave unconnected if unused.
SWEPT ALL-PASS STAGES (LM13700 OTA + buffer, 27k/27k/2k, 33n)
STAGES: 6 = AP1 + S1..S4 + AP2, 4 = AP1 + S3 + S4 + AP2
PHASE/FILTER: S3/S4 caps to the stage input (all-pass) or to ground (low-pass)
INPUT BUFFER, FIXED ALL-PASS 1 & REGEN (U3)
REGEN pot turns the feedback down to zero (original panned between two taps at full feedback)
FIXED ALL-PASS 2, MIX & LEVEL (U4)
LEVEL = output volume (original: 1 + 68k/pot, unlimited gain at one end)
LFO (U6A relaxation oscillator + U6B width amp) & CONTROL CURRENT
TIMING
CV feeds each OTA through its own 10k; 470k from +9V keeps every OTA slightly on
Timing cap: 2x 22u ceramic (original 47u); ceramic derating makes the LFO a bit faster
POWER, VREF & OFF-BOARD WIRING
U5B: REGEN summer, non-inverting x1.68: X = 1.68 (0.6 DRY + 0.4 REGEN). X feeds AP1 and MIX (2026-10-15 sim fix)
J1 = 9V, J2 = 9V ground, J4/J5 = jack grounds

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
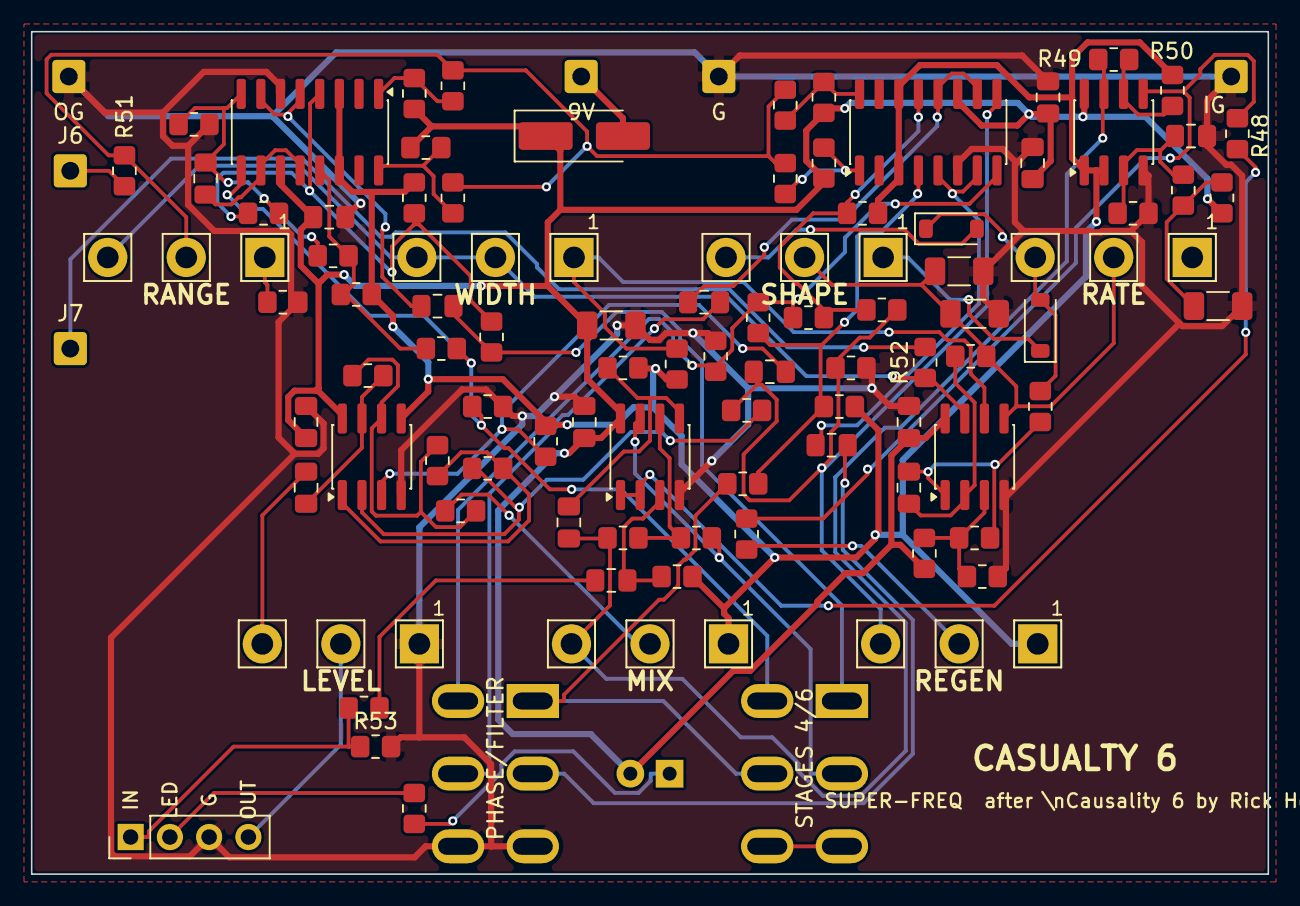
[picture p12: board Casualty6.kicad_pcb from above]

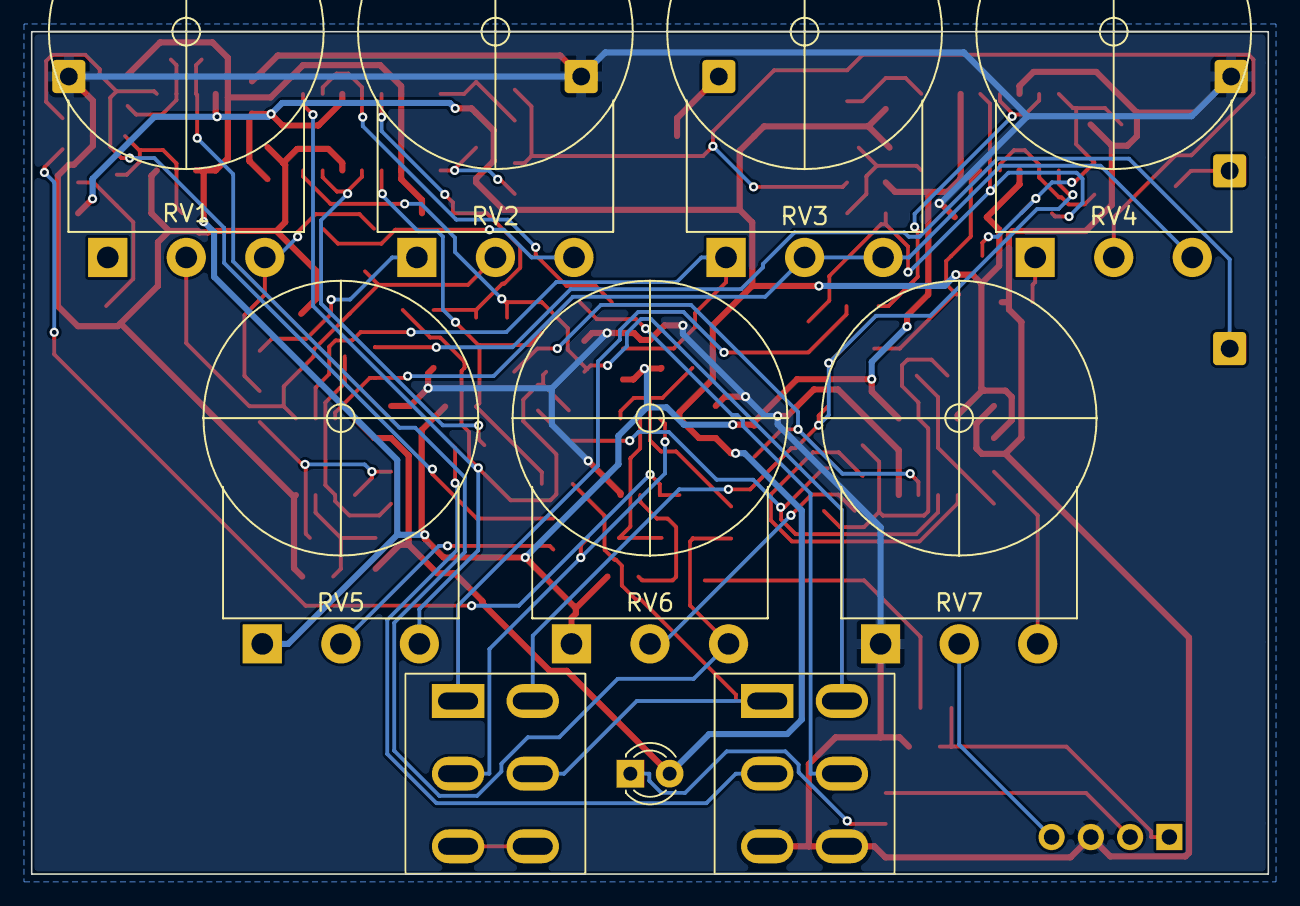
[picture p13: board Casualty6.kicad_pcb from below]

Board: 2 copper layers, 80.0 x 54.5 mm, 99 parts (3 on the bottom side), 61 nets.
