soggybag/Casualty-6-SMD/(commit log)

2026-10-15 Casualty 6 SMD: KiCad project (schematic, routed PCB, renders) and roadmap (random / S&H LFO, spin-off S&H filter pedal)
    [1590B.stp, Casualty6.kicad_pcb, Casualty6.kicad_sch, RV16AF-41.step]
2026-10-16 Casualty 6: REGEN fix (U5B non-inverting summer, R48-R50) from ngspice sim; slotted DPDT toggle footprint; full re-route (DRC 0); sim scripts and notes
    [Casualty6.kicad_pcb, Casualty6.kicad_sch]
2026-10-16 Casualty 6: CV IN (J6 + R51 10k) and LFO OUT (J7 + R52 1k) pads; full re-route (DRC 0)
    [Casualty6.kicad_pcb, Casualty6.kicad_sch]
2026-10-19 Casualty 6: pre-order review. RANGE loading fix (RV4 B10k, R43 2k2, Iabc resistors 15k), R53 1M input pulldown; re-routed (DRC 0/0/parity clean); notes
    [Casualty6.kicad_pcb, Casualty6.kicad_sch]
2026-10-19 Casualty 6: 1590BB drill guide (Tayda CSV, 1:1 template, README)
    [Casualty6_1590BB_drill.csv]
2026-10-20 U1-U6: FT Rotation Offset 270 (JLC preview needed 90 CW on 2 of 3 web uploads); order notes updated
    [Casualty6.kicad_pcb, Casualty6.kicad_sch]
2026-10-24 Archive v1.0: schematic and board PDFs, renders, interactive BOM, parts list, docs and fab files
    [Casualty6_1590BB_drill.csv, Casualty6_hand_solder.csv, bom.csv, designators.csv, parts.csv, positions.csv]
